meh-who/smart-tp-holder/docs/README.md

# Docs

| File | What |
|---|---|
| `assembly-guide.html` | **Start here.** Rev 2.0 build: wiring, NFC tag, mains power, flashing, calibration, server deploy, commissioning checklist, troubleshooting |
| `schematic.png` / `schematic.html` | Wiring schematic for rev 2.1: encoder + RC debounce, button, status LED, MAX98357A + speaker, USB power, NFC tag |
| `sensor-mounting.html` | Follower-arm geometry to scale: elevation, exploded assembly, contact inequality, wiring |
| `parts-list.html` | Bill of materials with prices (scroll-wheel build); the rev 2.0 delta is in the assembly guide |
| `technical-rider.md` | Technical rider for TEI '27 Arts & Performances (space, lighting, connectivity, furniture, equipment, install, maintenance) |
| `companion-page-preview.png` | The phone page after tapping the tag |
| `earlier-revisions/` | Rev A (Pi Zero 2 W), Rev B (wireless, scroll wheel), Rev C (ESP32-S3, battery) build documents — superseded but the reasoning is there |
