meh-who/smart-tp-holder/docs/companion-page-preview.png

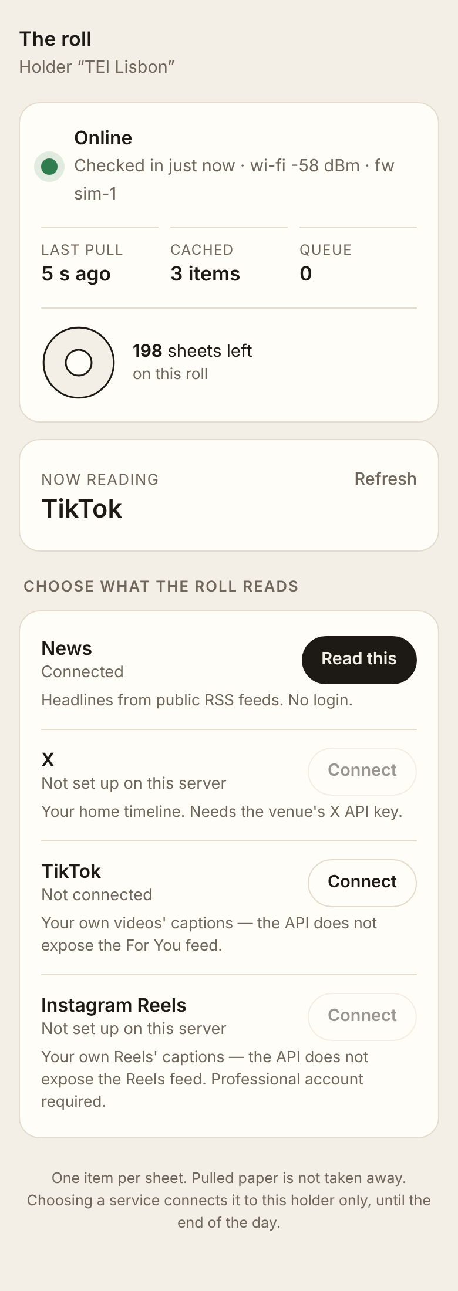
docs/companion-page-preview.png
