meh-who/smart-tp-holder/docs/schematic.png

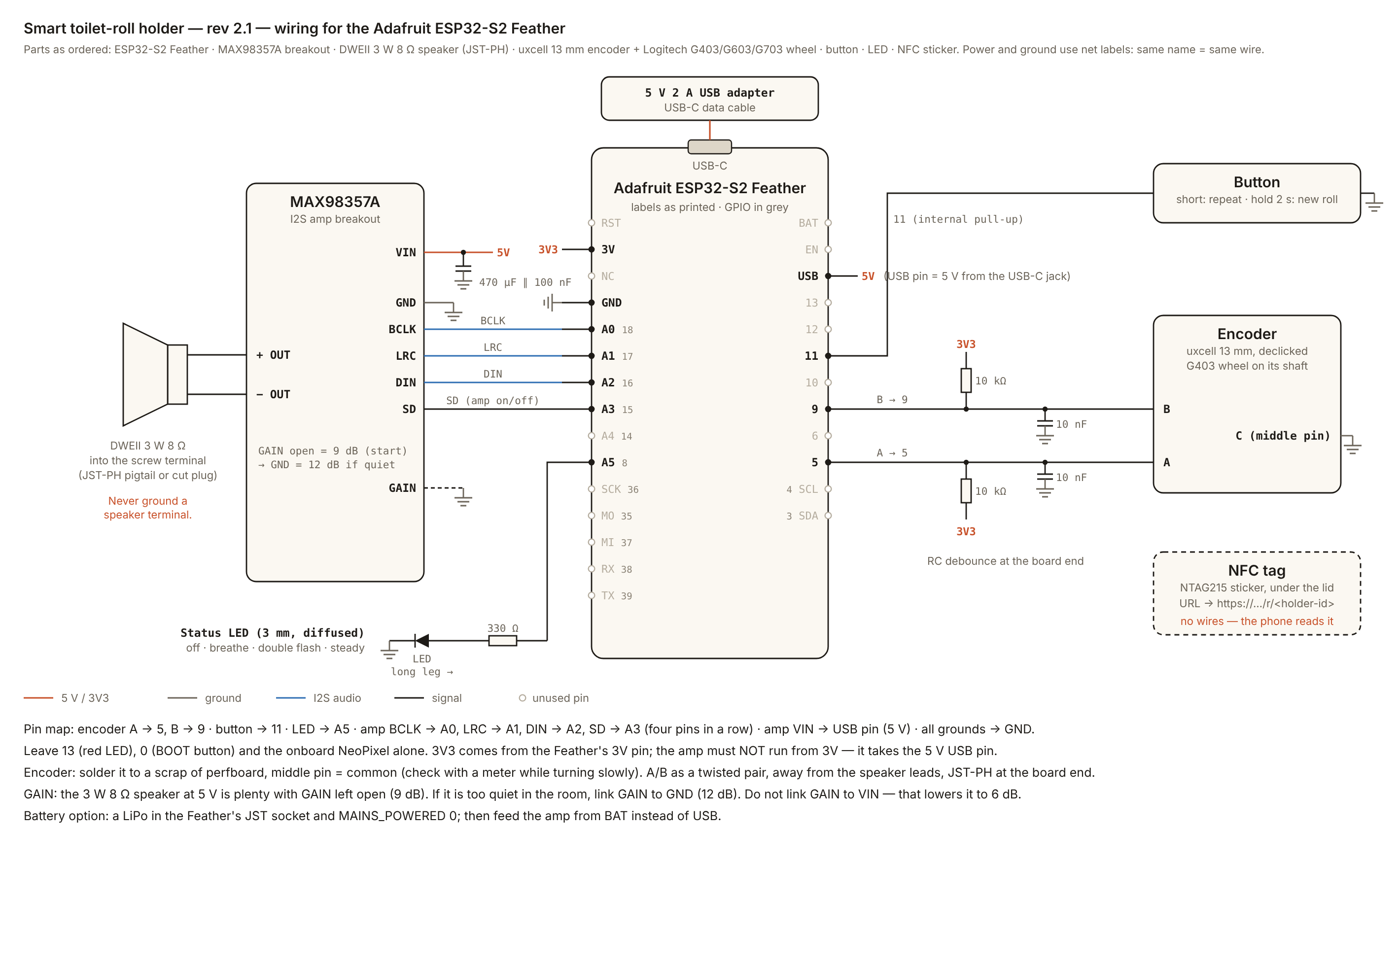
docs/schematic.png
