meh-who/smart-tp-holder/docs/earlier-revisions/rev-b-wireless-build.html

Revision BBattery poweredNo display≈$116

# Wireless build: schematic, layout, parts

E-ink removed, scroll wheel moved to the top of the roll, and the cable cut. Three changes, one of which is free, one of which is better than what it replaced, and one of which costs you a charging habit.

Sensing

2.75 mm

Idle draw

101 mA

Runtime

5.4 days

GPIO used

8 pins

Your sensing plan

01

## Riding the top of the roll is the right call

It's better than what I proposed, and worth being precise about why, because it looks like it shouldn't work.

A wheel resting on the roll doesn't measure angle — it measures surface travel. The paper leaving the roll and the surface passing under the wheel are the same material moving at the same speed. So the wheel turns once per π × 21 mm of paper no matter how fat the roll is. The diameter cancels out of the equation completely.

Roll diameter | Paper paid out in one roll turn | Wheel turns | Counts | Length read | Error
110 mm (fresh) | 345.6 mm | 5.24 | 125.7 | 345.6 mm | 0.00%
95 mm | 298.5 mm | 4.52 | 108.6 | 298.5 mm | 0.00%
80 mm | 251.3 mm | 3.81 | 91.4 | 251.3 mm | 0.00%
65 mm | 204.2 mm | 3.10 | 74.3 | 204.2 mm | 0.00%
44 mm (core) | 138.2 mm | 2.10 | 50.3 | 138.2 mm | 0.00%

Exact at every diameter. The whole SpindleLinearizer radius model is now dead weight in your build — it stays in the repo, tested, in case you ever want a paper gauge from the axle, but nothing calls it. Two tests were added that assert this directly.

### What it costs, and these are real

- The arm needs 33 mm of sprung travel. The contact point drops from r=55 mm to r=22 mm over one roll. A 70 mm follower arm sweeps that in about 40°, from 65° to 27° off vertical. Short arms won't reach the core; that's the number that sizes the mechanism.
- It counts roll spin, not hand pulls. Yank hard and the roll overspins, dumping slack the wheel dutifully measures. That paper genuinely left the roll, so it isn't wrong exactly — but it's why max_queue: 4 and max_backlog_s: 20 matter more in this version than the last.
- Contact pressure is the tuning knob. Too light and it slips and under-counts; too heavy and it compresses the outer layers and tears the sheet at the perforation instead of turning. Start light, add tension until three calibration runs agree within 3%.
- Resolution drops to 2.75 mm per count. Fine for 114 mm sheets, but the old 3 mm noise floor was under one count — a single spurious edge would have fired a headline. Default is now 6 mm (two counts).

Parts

02

## Everything you need to buy

Changes from the tethered version are marked. Prices are rough US street prices.

Part | Spec / why | Qty | ≈USD
Compute
Raspberry Pi Zero 2 W | Pre-soldered header version. No display means no SPI needed. | 1 | 18
microSD 16 GB, A1 rated | A1 matters — cheap cards make boot glacial. | 1 | 8
Sensing — the follower assembly
uxcell 25-pack mouse encoders | Use the 13 mm height — shorter ones put the metal can into the paper. Declick each one before fitting: the detent is what decides whether this part works. | 1 pk | 10
3 mm shaft + 2× MR63ZZ bearings | Low friction is critical — drag tears paper. | 1 | 6
Light torsion spring | ~5–15 gf at the contact patch. A rubber band works for v1. | 1 | 1
10 kΩ resistors, 10 nF caps | Debounce network on A and B. See the sizing note. | 2+2 | 1
Audio
MAX98357A I2S amp | 3 W mono straight off I2S. The Zero has no analogue out at all. | 1 | 6
40 mm 4 Ω 3 W speaker | Give it a sealed back volume or it sounds like a phone in a bucket. | 1 | 4
Power — this is the wireless part
5 V 2 A boost + LiPo charger with load sharing | 2 A, not 1 A — see the current budget below. Load sharing lets it run while charging. Must expose an LBO (low-battery) pin. | 1 | 20
LiPo 3.7 V 10,000 mAh pouch | Or 2× 18650 3500 mAh in parallel + holder. Must have a protection board. | 1 | 20
USB-C breakout for charging | Unless your charger board already has USB-C. | 1 | 3
1000 µF electrolytic, 10 V | Bulk cap across the amp's 5 V/GND. Rides out switching transients. | 1 | 1
100 nF ceramic | Decoupling at the amp VIN pin. | 2 | 1
SPDT slide switch | On the charger's EN pin — a real off switch. | 1 | 1
Misc
Momentary tactile button | Short press = repeat, hold 2 s = new roll. | 1 | 1
JST-PH connectors, wire, heat shrink | Use connectors — you will open this thing repeatedly. | — | 7
PETG filament | Not PLA. Hot showers warp PLA and a warped arm ruins calibration. | — | 5
Total | | | ≈116

Spec the 2 A boost, not the 1 A

I costed the 1 A module first and it doesn't survive the arithmetic. The Pi peaks around 600 mA on a WiFi transmit burst; the MAX98357A driving 4 Ω at full tilt pulls about 950 mA. Worst case those coincide at 1.55 A. The 1000 µF bulk cap only rides out about 0.47 ms before sagging — enough for a switching transient, nowhere near enough for a loud sentence. Either fit a 2 A module, or keep volume ≤ 0.8 and accept brownout risk. The 2 A module costs a few dollars more; take the module.

Schematic

Eight GPIO in total, no bus conflicts. The amp's SD_MODE line is doing double duty: it's the mute control and the idle power saving, worth ~14 mA and all of the idle hiss.

### Pin assignments

Signal | BCM | Header pin | Goes to | Note
I2S BCLK | GPIO18 | 12 | MAX98357A BCLK | PCM_CLK
I2S LRCLK | GPIO19 | 35 | MAX98357A LRC | PCM_FS
I2S data | GPIO21 | 40 | MAX98357A DIN | PCM_DOUT
Amp shutdown | GPIO23 | 16 | MAX98357A SD_MODE | high = on/left, low = sleep
Encoder A | GPIO5 | 29 | scroll wheel A | via RC, internal pull-up
Encoder B | GPIO6 | 31 | scroll wheel B | via RC, internal pull-up
Button | GPIO16 | 36 | button → GND | internal pull-up
Battery low | GPIO26 | 37 | charger LBO | open drain, low = trouble
5 V in | — | 2, 4 | boost 5 V out | bypasses input protection
Ground | — | 6, 9, 14, 20 | star ground | one point at the charger

Why 10 kΩ + 10 nF and not 10 kΩ + 100 nF

A hard yank moves paper at roughly 1 m/s, which at 2.75 mm/count is 364 counts/s — a 2.7 ms period, so 1.4 ms per half-cycle. A 10 kΩ/100 nF network has a 1 ms time constant and would smear that into mush. 10 kΩ + 10 nF gives 100 µs, roughly 14× faster than the fastest edge you'll ever see, while still killing contact bounce. If you're using an optical encoder you can skip the RC entirely.

Layout

Battery at the back and low — it's by far the heaviest component and a wall-mounted holder with mass up front will sag on its fixings over time.

Runtime

03

## How long it actually lasts

You asked for wireless, so here are the honest numbers rather than the ones I'd like to give you. Measured assumptions: headless Pi with WiFi associated, our poll loop, six uses a day at 25 seconds of speech each.

Draw | Current @5 V | Notes
Pi Zero 2 W idle, WiFi on | 115 mA | the floor — you cannot get under this
Poll loop at 200 Hz | 28 mA | drops to ~8 mA at the 40 Hz idle rate
Amp idle, un-muted | 14 mA | reclaimed by the SD_MODE pin
WiFi power-save | −25 mA | enabled by the setup script
Optimised idle | 101 mA | ≈0.5 W
Talking | 341 mA | 2.5 min/day, so barely moves the average

Battery | Capacity | Runtime | Verdict
2× 18650, parallel | 7,000 mAh | 1.9 days | too often
10,000 mAh LiPo | 10,000 mAh | 2.7 days | twice a week
20,000 mAh pack | 20,000 mAh | 5.4 days | weekly — the sweet spot
30,000 mAh pack | 30,000 mAh | 8.1 days | big and heavy on a wall

The thing you should know before buying the battery

A Pi Zero 2 W has no usable sleep state, so that 115 mA floor runs 24 hours a day whether anyone uses the holder or not. Every software trick combined buys about 30%, not 10×. That's why the runtime ceiling is days, not months.

An ESP32-S3 doing the same job — deep sleep at ~18 µA, woken by the encoder edge, WiFi up for four seconds every half hour — comes to about 12.6 mAh/day. A small 2,000 mAh cell would then last five months, in a package a fraction of the size.

My suggestion: build it on the Pi with a 20,000 mAh pack and live with charging it on Sundays. The interaction is what you're still designing, and Python on a real Linux box is the right place to be iterating. Port to the ESP32 once you've stopped changing your mind about how it should feel — geometry.py and motion.py translate to C++ almost line for line, and they're the only parts with any subtlety in them.

Bring-up

04

## Assembly order

Build it in this order. Each step is testable on its own, which matters because debugging all of it at once is miserable.

1. Pi on USB power, no peripherals. Flash Raspberry Pi OS Lite 64-bit, get it on WiFi, run sudo bash hardware/setup-pi.sh, reboot.
2. Audio only. Wire the amp and speaker. aplay -l must show a hifiberry card; speaker-test -c1 -t sine -f 440 -l1 must make a noise. Nothing else works until this does.
3. Encoder on the bench, wheel in your fingers. Wire A/B/common with the RC network. Spin it by hand and watch the count move both ways:

# must go up AND down
python3 -c "from gpiozero import RotaryEncoder; import time; \
e=RotaryEncoder(5,6,max_steps=0); \
[print(e.steps) or time.sleep(.2) for _ in range(50)]"

4. Power chain, still on the bench. Battery into the charger, switch, 5 V out measured with a meter before it touches the Pi. Confirm it holds ≥4.9 V while the amp plays loudly. This is where a 1 A module fails.
5. Mechanical assembly. Arm, spring, wheel on the roll. Check the wheel still contacts a nearly-empty roll — wind one down or shim a 44 mm core to test it.
6. Calibrate. Three runs of tools/calibrate.py, paste mm_per_count, confirm the spread is under 3%.
7. Set sensor.kind: quadrature in the config and start the service. If pulling paper makes the count go down, set invert: true rather than swapping wires.

### What changed in the code

- display.py is gone. Along with SPI, Pillow, the Waveshare vendoring step and the draw thread. The low-paper readout it used to show is now spoken instead, once, below 12 sheets.
- power.py is new. Amp shutdown control and the low-battery watchdog, which warns out loud then halts cleanly after five minutes — a Pi that browns out mid-write corrupts its SD card, and nobody is watching this one.
- The loop idles down. 200 Hz while paper moves, 40 Hz after eight seconds of quiet.
- noise_floor_mm is 6.0, not 3.0. Two counts at scroll-wheel resolution instead of one. There's a test asserting this stays true if you change the wheel.
- 21 tests now, up from 16. The new ones cover the surface-wheel geometry at five roll diameters and the amp's wake/release logic.

Broadsheet rev B · 21 tests, no hardware required · geometry.py and motion.py are the files worth reading
