meh-who/smart-tp-holder/docs/earlier-revisions/rev-c-esp32-plan.html

Revision CESP32-S3≈$703 months a charge

# The same product, on a microcontroller

213× less energy per day than the Pi, and it feels faster rather than slower. Two decisions make that true, and neither is the one you'd guess: the sleep mode is the shallow one, and most of the software leaves the device entirely.

Per day

17.5 mAh

On 2000 mAh

97 days

Wake latency

15 ms

Port verified

43/43

The headline number

01

## Why it's worth doing at all

Same job, same six-uses-a-day duty cycle, same speech:

Platform | Energy/day | 2000 mAh | 10,000 mAh | 20,000 mAh
Raspberry Pi Zero 2 W | 3,722 mAh | 0.5 days | 2.3 days | 4.6 days
ESP32-S3 | 17.5 mAh | 97 days | 486 days | 971 days

The 20,000 mAh column is a joke you should ignore — the point is that 2000 mAh, a cell the size of a credit card and half a centimetre thick, gives you a quarter of a year. The Pi needs a pack forty times heavier to manage five days. That's not a tuning difference, it's a different class of object: one you hang on a wall and forget, versus one with a charging habit attached.

Decision one

02

## Light sleep, not deep sleep

I told you last time this would run on deep sleep at 18 µA. Having worked through the wake path, that's wrong, and it's worth showing why because the mistake is seductive.

Deep sleep powers down the CPU and most of RAM. Waking means the ROM bootloader runs, the app is re-loaded from flash, LittleFS remounts, I2S re-initialises — before a single sample reaches the amp:

Deep sleep wake path | ms | cumulative
RTC wake + ROM bootloader | 140 | 140
2nd-stage bootloader + app load from flash | 110 | 250
LittleFS mount | 90 | 340
I2S + PCNT init | 12 | 352
Open file, decode first MP3 frame | 14 | 366
MAX98357A un-mute settling | 30 | 396
Total | | 396 ms

That's twice the 200 ms budget the entire product is built around. Deep sleep would buy world-class battery life and hand back a device that feels broken on every single pull — trading away the only thing that makes the interaction work.

Light sleep keeps RAM powered. The filesystem stays mounted, I2S stays configured, execution resumes at the next instruction:

Light sleep wake path | ms | cumulative
GPIO edge wake | 1 | 1
RAM retained — no remount, no re-init | 0 | 1
Open file, decode first MP3 frame | 14 | 15
Amp already woken at PULL_STARTED, 33 mm earlier | 0 | 15
Total | | 15 ms

250 µA instead of 18 µA — about 6 mAh a day, a third of the total budget. Worth every microamp. Deep sleep still appears in the firmware, but only after three hours of no use, where 400 ms on the first pull of the morning is genuinely unnoticeable.

The knock-on effect

A 250 µA sleep budget has a consequence the Pi build never had to think about: you cannot have a boost converter. A typical 5 V boost module idles at 10–20 mA, which is forty to eighty times the entire sleep budget. It would dominate everything.

So the ESP32 build has no 5 V rail at all. The board runs from the cell through its own LDO, and the amp runs straight off the cell too — a bridge-tied MAX98357A at 3.7 V still delivers 1.7 W into 4 Ω, and speech in a small tiled room needs well under one. One fewer module, one fewer failure mode, and the sleep budget survives.

Decision two

03

## Most of the software doesn't move

The instinct on a platform port is to rewrite everything in C++. Don't. RSS parsing, fuzzy dedupe, the gentle-mode filter and a TLS call to a TTS vendor are all memory-hungry, all change often, and a microcontroller in a bathroom is the worst place on earth to maintain any of them.

So they don't move. newsroom.py and tts.py run unchanged on a server — a Pi already in the house, a NAS, a cheap VPS, or cron pushing to an S3 bucket. They write a static folder. The ESP32 fetches a manifest once an hour and plays files.

The split isn't about firmware effort — it's that the interaction stays tunable by editing Python. Change how it feels, and the device picks it up on its next hourly sync instead of needing a reflash.

Measured, not estimated — I built a real bulletin with the existing pipeline:

Flash and sync budget | measured
One headline, 64 kbps mono MP3, 4.3 s | 34 KB
20 headlines + 4 system clips | 543 KB
Fits a 6 MB LittleFS partition | 11× over
Full cold download at ~400 kbit/s | 4.9 s
Typical hourly sync (incremental) | ~5 s

543 KB is small enough that there is no SD card in this design. One less connector to corrode in a humid room, and one less mount step in the wake path.

The port

04

## Proving the gesture engine survived translation

motion.py is where all the subtlety lives, and a hand-translation of it into C++ is exactly the kind of change that looks correct and isn't. The failure modes are invisible on a read-through: the falsy-zero guard that skips the first speed sample, the reverse-credit clamp, whether last_motion_at survives a PULL_ENDED.

So bs_motion.cpp has no Arduino, ESP-IDF or FreeRTOS dependency at all. It compiles on a laptop, and the same pull traces run through both implementations and get diffed field by field:

$ cd esp32/test
$ g++ -std=c++17 -Wall -Wextra -I../include native_trace.cpp ../src/bs_motion.cpp -o trace
$ python3 ../tools/diff_python_cpp.py

scenario      events  result
----------------------------------------------------
normal3            5  identical
hesitant           5  identical
twopulls           6  identical
rewind             5  identical
bump               0  identical
runaway            6  identical
single             3  identical
shorttug           3  identical
creep              4  identical
slowdrift          6  identical
----------------------------------------------------
10 scenarios, 43 events, 0 mismatch(es)

This runs as part of pytest too (22 tests now), so the two can't quietly drift apart later. If you tune first_trigger_mm in the Python and forget the C++, the suite tells you.

geometry.py barely needed porting. Because the wheel rides the roll's surface, the whole file is one multiply — the shrinking-radius model that the spindle version needs simply doesn't exist here.

Parts

05

## Bill of materials

Cheaper and simpler than the Pi build: no boost converter, no SD card, no 20,000 mAh brick.

Part | Spec / why | ≈USD
Compute + power
ESP32-S3 board with LiPo charging | Must have a JST-PH battery connector and onboard charging — e.g. Adafruit ESP32-S3 Feather, Unexpected Maker TinyS3, Seeed XIAO ESP32S3. 8 MB flash minimum; 16 MB gives you OTA plus a roomy filesystem. | 15
LiPo 3.7 V 2000 mAh | ~97 days. With protection board. No boost, no charger module — the dev board does both. | 9
2× 100 kΩ resistors | Battery sense divider into ADC1. | 1
Audio
MAX98357A I2S amp | Same part as the Pi build. Runs straight off the cell at 1.7 W into 4 Ω. | 6
40 mm 4 Ω 3 W speaker | Sealed back volume, as before. | 4
470 µF + 100 nF | Bulk and decoupling at the amp. | 1
Sensing — unchanged from Revision B
uxcell 25-pack mouse encoders | 13 mm height. Declicked before fitting. | 10
Shaft, 2× MR63ZZ bearings, torsion spring | The 33 mm follower arm. | 7
Printed hub + O-rings | ~17 mm ID × 2 mm section; the tyre. | 3
2× 10 kΩ, 2× 10 nF | Debounce on A and B. The PCNT glitch filter is belt to this braces. | 1
Misc
Momentary button, wire, JST connectors | Repeat / new roll. | 6
PETG filament | Not PLA. | 5
Total | | ≈70

### Pin assignments

GPIO 0–21 on the S3 are RTC-capable, which is why the encoder and button sit down there — only those can wake the chip from deep sleep.

Signal | GPIO | Goes to | Note
Encoder A | 4 | scroll wheel A | RTC-capable; wakes from both sleep modes
Encoder B | 5 | scroll wheel B | RTC-capable
Button | 6 | button → GND | internal pull-up
I2S BCLK | 15 | MAX98357A BCLK | any GPIO — the S3 uses a matrix
I2S LRCLK | 16 | MAX98357A LRC
I2S DOUT | 17 | MAX98357A DIN
Amp shutdown | 18 | MAX98357A SD_MODE | high = on/left, low = asleep
Battery sense | 1 | 2:1 divider from BAT+ | ADC1_CH0, eFuse-calibrated read
Amp VIN | — | BAT+ direct | not 3.3 V — the LDO can't take the peaks

Power

06

## Where the 17.5 mAh goes

Contributor | mAh/day | share | What would reduce it
Audio playback | 6.88 | 39% | nothing worth doing — this is the product working
Light sleep floor | 5.98 | 34% | deep sleep, at the cost of the whole interaction
WiFi sync | 4.17 | 24% | the sync interval — the one real dial
Awake / counting | 0.51 | 3% | already negligible at 80 MHz idle
Total | 17.54 | 100%

The sync interval has a knee, and it's at about an hour

Battery life on a 2000 mAh cell vs how often the device fetches the bulletin

Past about two hours it stops paying: light sleep and audio dominate, and the radio is no longer the problem. An hour is the sensible default — news that's 60 minutes stale is still news.

Risks

07

## What I can't verify from here

The gesture engine is proven. These are the parts that need a board on a bench.

- PCNT API version. encoder.cpp uses driver/pulse_cnt.h, the ESP-IDF 5.x API that ships with Arduino-ESP32 3.x. On 2.x you need the older driver/pcnt.h and the calls differ. platformio.ini pins the newer one, but this is the first thing that will bite you.
- Audio library churn. ESP8266Audio's I2S wrapper has moved around across Arduino-ESP32 versions. Everything library-specific hides behind three void* members in player.h, so ESP32-audioI2S is a contained swap if it fights you.
- The 250 µA light-sleep figure. It's the datasheet-plus-experience number for an S3 with WiFi off and RAM retained. Real dev boards leak — a power LED alone is 2–5 mA, which would be ten to twenty times the sleep budget. Measure it, and be prepared to desolder LEDs and check what the onboard USB-serial chip does when idle.
- setInsecure() in sync.cpp. Fine fetching your own bulletin off your own LAN. Pin a root CA before it talks to anything you don't control.
- Counts lost at wake. PCNT doesn't run during light sleep, so the edge that wakes the chip isn't counted. That's 2.7 mm against a 45 mm first trigger — it vanishes into the noise gate, but it's a real known loss rather than something I've hidden.

What to do

08

## The order I'd actually do this in

My advice hasn't changed: don't port yet. Build Revision B on the Pi, live with it for a few weeks, and find out whether one-sheet-one-headline is the right interaction or whether depth-into-one-story is. That question is worth more than three months of battery life, and Python on real Linux is where you want to be while it's open.

The ESP32 build is what you do once you've stopped changing your mind. When that happens:

- Stand up the server first. python3 server/build_bulletin.py --out public --serve on whatever machine is already on in your house. Point a browser at bulletin.json and confirm it looks right. This works today, with no ESP32 in the room.
- Run the port diff before you flash anything. If the gesture engine is wrong, every symptom above it will mislead you.
- Bring up audio alone. Board, amp, speaker, one MP3 on LittleFS, no encoder and no sleep. Nothing else matters until this is clean.
- Then the encoder, then sync, then sleep — in that order. Sleep last, always. Debugging a chip that keeps going to sleep while you're trying to talk to it is its own special misery.
- Measure the sleep current before you trust any of my numbers. A multimeter in series with the cell, everything idle. If it isn't in the hundreds of microamps, something on that dev board is awake that shouldn't be.

Broadsheet rev C · 22 tests including the C++ port diff · bs_motion.cpp and motion.py must stay identical
