meh-who/smart-tp-holder/firmware/holder/secrets.example.h

// secrets.example.h — copy to secrets.h and fill in. secrets.h is git-ignored.
#pragma once
#define WIFI_SSID   "YOUR-WIFI-NAME"
#define WIFI_PASS   "YOUR-WIFI-PASSWORD"
#define HOLDER_KEY  "same-key-as-the-HOLDERS-variable-on-the-server"
