meh-who/smart-tp-holder/(commit log)

2026-10-25 Add web control for the smart toilet paper holder
    NFC landing page showing holder status and the line being read,
    source switching (News, X, TikTok, Reels), visitor account
    connection with in-memory tokens that expire, a WebSocket link
    for the holder firmware, a holder simulator, and demo mode.
    Claude-Session: https://claude.ai/code/session_01EqVY4WfR7Du3zTHoYE2Jxo
2026-10-25 Replace Node web control with the Python server, ESP32-S3 firmware and assembly guide
    The previous web control sent the holder plain text over a WebSocket and
    left text-to-speech to the device, which an ESP32 cannot do on its own.
    This version synthesises speech on the server, caches it as 64 kbps MP3s
    and ships a bulletin the holder downloads; the firmware here matches it.
    - firmware/holder: Arduino sketch (encoder → gesture engine → I2S player,
    heartbeat + bulletin sync on core 0, source switch announced by voice)
    - firmware/test: gesture engine scenarios, runnable with g++
    - server: FastAPI companion page + holder API, OAuth for X/TikTok/Instagram,
    RSS news, curated-set fallback,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
    [bs_motion.cpp, bs_motion.h, config.h, holder.ino]
2026-10-28 Rev 2.1: status LED (breathe / double flash / steady), page-open signal from server, wiring schematic
    Claude-Session: https://claude.ai/code/session_017XeD6znSswNuAHEPNtwiBp
2026-11-01 Rev 2.1 for the Adafruit HUZZAH32: pin map, bring-up sketch, schematic, assembly steps
    - config.h picks HUZZAH32 pins automatically on an ESP32 target
    - firmware/bringup: bench test for LED, amp + speaker, encoder, button
    - schematic redrawn on the HUZZAH32 header as printed
    - fix GAIN note: open = 9 dB, to GND = 12 dB (to VIN is 6 dB)
    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
    [bringup.ino, config.h, holder.ino]
2026-11-01 Target the Adafruit ESP32-S2 Feather: pin map, single-core playback guard, schematic, guide
    - config.h / bringup: ESP32-S2 Feather pins (amp on A0-A3, LED A5, encoder 5/9, button 11)
    - sync: on single-core chips, wait for the current clip before TLS work or downloads
    - upload notes: USB CDC on boot, BOOT+RESET for the first upload
    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
    [bringup.ino, config.h, holder.ino, sync.cpp]
2026-11-04 Server: deployable from a dashboard (Railway/Render) with no shell
    - HOLDERS env var registers holder ids/keys at startup
    - Dockerfile listens on $PORT when the host sets one
    - server/railway.json: Dockerfile build, /healthz check
    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
2026-11-04 Firmware config for the Railway server; wi-fi and key move to git-ignored secrets.h
    - config.h: SERVER_URL set to the Railway deployment, includes secrets.h
    - secrets.example.h template; secrets.h ignored
    - server/Dockerfile: drop VOLUME (Railway rejects it; a Railway volume is mounted at /data)
    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
2026-11-04 Companion page redesign: the roll as a scrolling number wheel
    Sheets left shown on a half-disc drum that rolls to the live count, ticks on
    each pull, and can be flicked by hand. Feed / Status / Last pull below; the
    feed picker opens with a cancel / confirm footer. Light and dark.
    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
2026-11-04 Count sheets up from 0; New roll button resets the count on the page and the holder
    - page: wheel counts sheets pulled (up from 0, scrolling upward); New roll with confirm
    - server: POST /new-roll, roll_reset_ts in the heartbeat reply, page shows 0 until the holder confirms
    - firmware: applies a page-requested new roll once (persisted), one new_roll() for button/console/page
    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
    [holder.ino, sync.cpp, sync.h]
2026-11-04 Companion page: no bottom bar, whole roll in view; fix 'last pull' before the first pull
    - ✕/✓ bar appears only while choosing a feed or confirming a new roll
    - roll sized to fit the stage top to bottom
    - firmware: send 'never' as signed -1 (was ~4.3e9 s unsigned); server ignores impossible values
    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
    [sync.cpp]
2026-11-05 firmware: encoder wiring check (raw pin readout in bring-up, 'enc' live count in the holder); filter 1000
    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
2026-11-05 Live sheet count: report each sheet as it is pulled (fw 2.2)
    The page polled every second but the holder only reported every 20 s, only
    charged a pull once the paper had been still for 1.5 s, and held every report
    until it stopped speaking. Now:
    - holder: counts the pull in progress (rounded the way the session end will
    charge it, so the number never jumps back) and heartbeats as soon as it
    changes, at most every 500 ms (MIN_BEAT_MS)
    - holder: heartbeats reuse one kept-alive TLS connection, so they can go out
    mid-sentence; a reconnect, bulletin fetch or download still waits for quiet,
    and free space is only measured between clips
    - server: asks for a beat every 2 s while a phone has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
2026-11-05 Holder: keep as many clips as fit, keep the system clips, add a sync simulation
    - The S2 Feather's LittleFS is ~1.9 MB and a clip ~107 KB, so a 24-item
    bulletin never fits. Downloads now stop at the free-space limit, keep what
    fits (about 15 items) and only retry if that pass made progress or freed
    the previous bulletin's clips, instead of failing writes on a full disk.
    - sweep() kept system clips by a "sys_" prefix the server never uses, so it
    deleted them after every download; it now keeps whatever the bulletin uses.
    - firmware/test/sync: runs the real sync.cpp on a laptop against a fake
    server, clock, filesystem and visitor (./run.sh). Fresh boot with pulls
    during the full dow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
    [sync.cpp]
2026-11-05 Holder fw 2.4: keep internal RAM whole so TLS can reconnect; self-heal
    Telemetry from 2.3 showed the S2 with ~49-54 KB of internal heap and no TLS
    session: the first handshake at boot fits, but once the connection dropped
    (a download stalled) every reconnect failed and the holder fell silent.
    mbedTLS here may only use internal RAM and needs ~40 KB, two ~17 KB blocks.
    - MP3 decoder buffers allocated once (PSRAM) and one reused file reader,
    instead of allocating per clip, which broke up the internal heap
    - bulletins (PSRAM, capped at the server's 24 items) and every JsonDocument
    (PSRAM allocator) off the internal heap: static RAM 88.2 -> 81.1 KB
    - a clip is received whole into a 256 KB PS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
    [config.h, holder.ino, player.cpp]
